Pazcaut/Amplificador-AB-100W/README.md

# Amplificador-AB-100W
Amplificador de potencia de audio en Clase AB de 100W sobre 8Ω

Diseño, testeo y análisis de un amplificador de audio AB.

Objetivos:
Analizar su funcionamiento y comparar la teoría con la realidad. 
Evaluar la calidad y la potencia de la señal de salida. 
Medir interferencia y la protección contra cortocircuitos. 

Todas las mediciones se realizaron sobre una carga de 8 ohms y luego se le conectó una señal de audio por celular y un parlante para corroborar el funcionamiento.
Se adjunta esquemático en KiCad y la comparación de cálculos teóricos con las mediciones en laboratorio, con sus respectivas capturas de pantalla del osciloscopio.
Fotografia de la placa terminada:
