Pazcaut/Amplificador-AB-100W/Ampli AB.pdf

# Amplificador AB

### CLASE AB 100W

PAZ CAUT VILLA

Electrónica Aplicada II

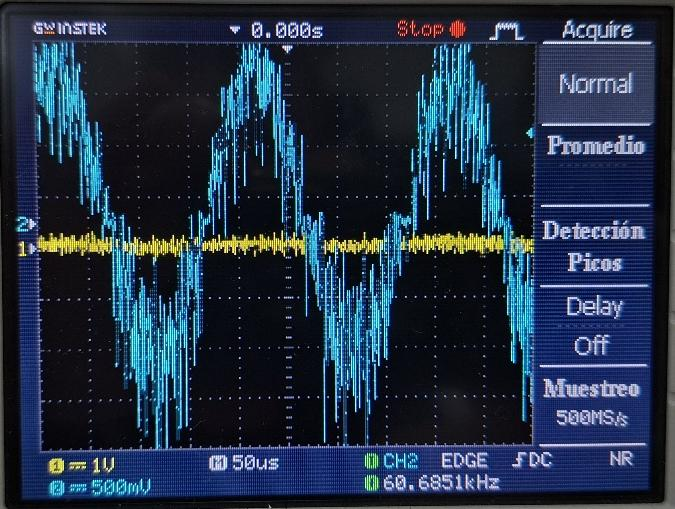
[picture p1: figure]

____________________________________________________________________________

Objetivos del trabajo

En el presente trabajo práctico, se realizaron mediciones sobre un amplificador de Potencia de audio en Clase AB de 100W sobre 8Ω.

La práctica permitió conocer y experimentar el funcionamiento de los principales bloques que comprende un amplificador de potencia de audio Clase AB discreto.

Antes de alimentar el circuito, se ajustó el preset RV1 en 0Ω. Esto asegura que no habrá corriente de reposo en los transistores de salida Q7 y Q8; o sea, que estarán en Clase B y no en Clase AB. Se conectó como carga, en lugar del parlante, una resistencia de 8Ω.

La prueba final, después de las mediciones, se realizó utilizando un parlante y música.

Mediciones a realizar

El circuito se alimentó con una fuente simétrica de Vcc = ±35V.

1. Nombrar cuál de las 4 topologías de realimentación (C-P, C-S, T-P, T-S) utiliza este circuito; y el tipo de amplificador (Avf, Aif, Rmf, Gmf) que es. Teniendo en cuenta solamente la red de realimentación Beta; calcular la Ganancia Realimentada (a Lazo cerrado) del circuito.

El circuito corresponde a un amplificador tensión- serie. Se muestrea tensión y se realimenta tensión. Por lo tanto, es un amplificador de tensión, con ganancia Avf.

La ganancia de lazo cerrado es:

Avf = 1 +

R3
R2

→ Avf = 1 +

3300
100

→ Avf = 34

### 2. Verificar la distorsión por cruce. Ajustar RV1 hasta observar su corrección. Colocar

capturas del osciloscopio antes y después de la corrección.

Señal de salida antes de corregir distorsión por cruce.

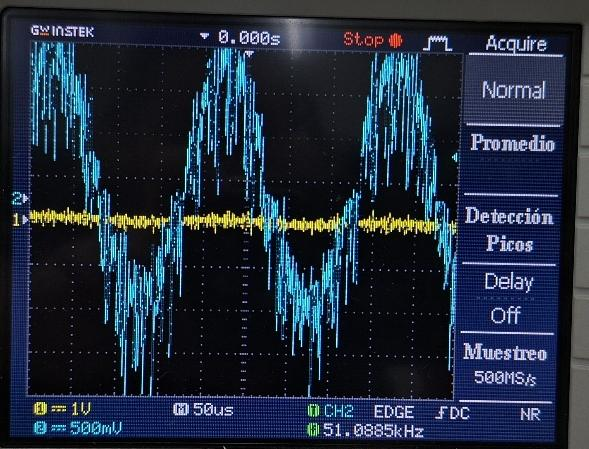
[picture p2: figure]

____________________________________________________________________________

Señal de salida después de corregir distorsión por cruce.

3. Medir los puntos Q de todos los transistores.
TR | VCEQ [v] | ICQ [mA]
Q1 | 29,62 | 1,28
Q2 | 30,24 | 1,28
Q3 | 28,52 | 1,54
Q4 | 3,78 | ~0
Q5 | 3,15 | ~0
Q6 | 2,04 | 1,04
Q7 | 29,7 | 1,03
4. Medir la máxima excursión de salida. Indicar la sensibilidad del amplificador (señal de entrada para obtener máxima señal de salida). Indicar si es simétrica la excursión. Calcular la ganancia de tensión. Colocar captura de pantalla del osciloscopio que compare señal de entrada y de salida.

La máxima excursión de salida se dio con Vo ≈ ±29.5V y con Vin = ±840mV

Av =

Vo
Vin

→ Av =

29.5V
840mV

→ Av = 35. 1

Se observó que la excursión de salida es practicamente simétrica.

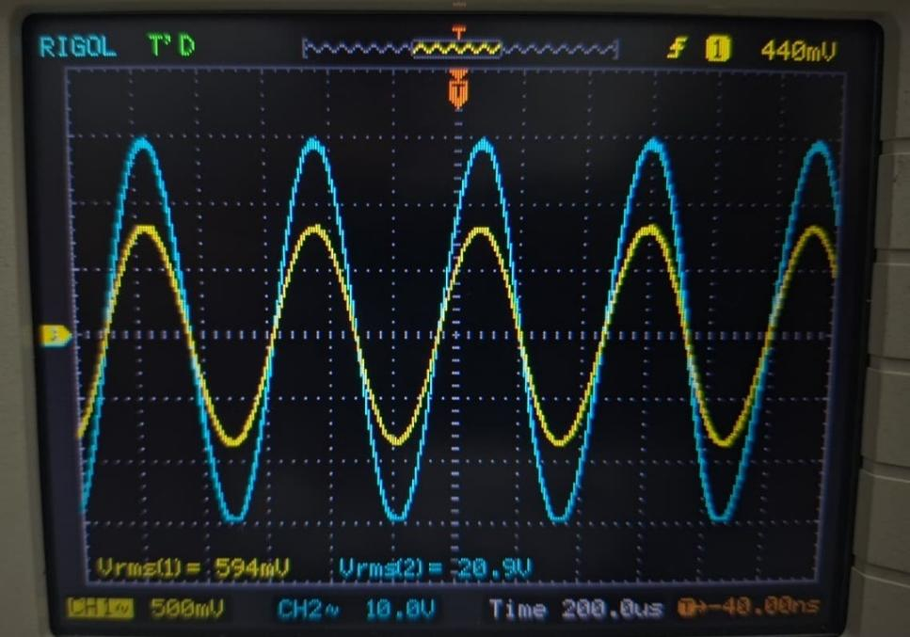
[picture p3: figure]
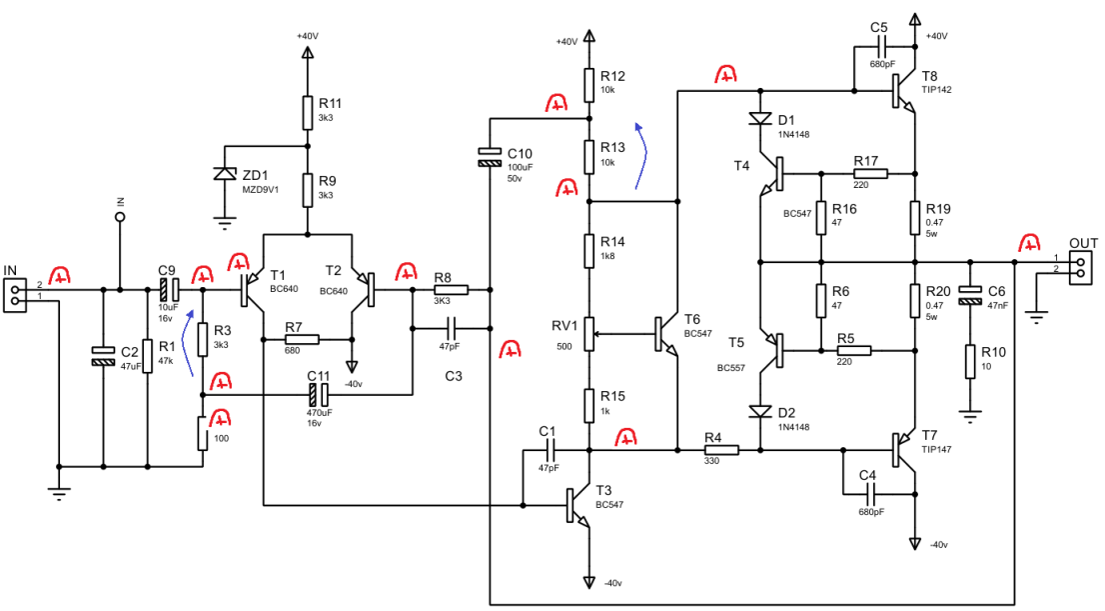
[picture p4: figure]

____________________________________________________________________________

Señal de salida (celeste) y señal de entrada (amarillo).

5. Verificar Bootstrap de entrada y de salida. Indicar cómo funciona y medir la tensión en los extremos de las resistencias involucradas, y realizar la resta de tensiones con el osciloscopio. Coloque una captura de pantalla del osciloscopio. Calcular la corriente de alterna que circula por dichas resistencias.

El Bootstrap se utiliza para aumentar la impedancia en alterna de una resistencia. En un extremo de la resistencia está presente determinada tensión de alterna. Mediante un capacitor, en el otro extremo se inyecta una tensión muy similar, haciendo que la caída de tensión en la resistencia sea casi nula, y no circule corriente.

En el siguiente circuito se observan el Bootstrap de entrada (conformado por C11 y R3) y el Bootstrap de salida (conformado por C10 y R12/13).

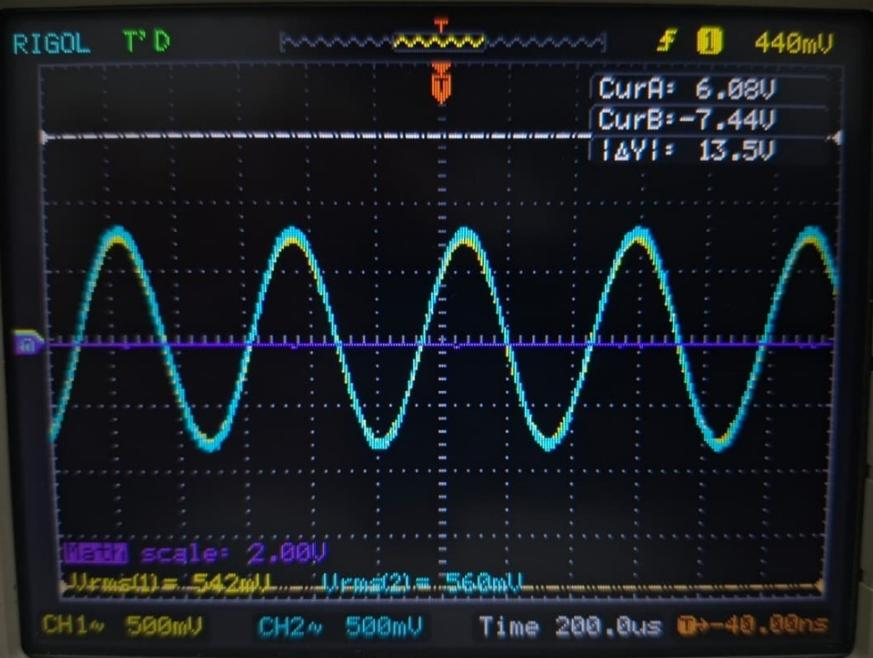
[picture p5: figure]
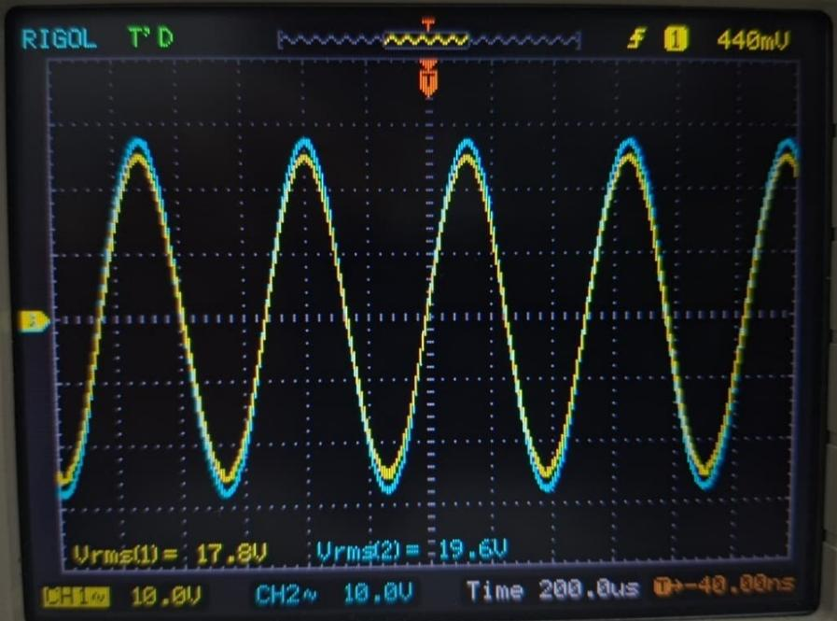
[picture p6: figure]

____________________________________________________________________________

La corriente que circula por las resistencias se obtiene observando la caída de tensión en el osciloscopio.

Bootstrap de entrada, compuesto por C11 y R3.

Bootstrap de salida, compuesto por C10 y R12/13. VR3 = (560mV − 542mV)√2 → VR3 = 25.5mV̂

VR13 = (19.6V − 17.8V)√2 → VR13 = 2.55 V̂

IR3 =

25.5mV̂
3300Ω

→ IR3 = 7. 7 uA

IR13 =

2.55V̂
10000Ω

→ IR13 = 255 uA

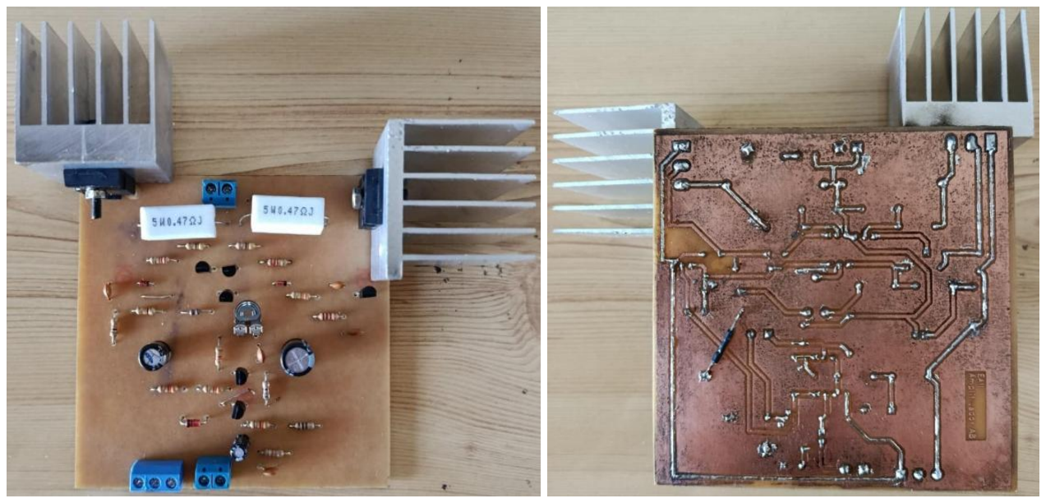
[picture p7: figure]

____________________________________________________________________________

6. Medir el rendimiento del amplificador.

PoutMáx Teo =

Vcc²
2 ∗ RL

→ PoutMáx Teo =

(35V)

2
2 ∗ 8Ω

→ PoutMáx Teo = 76. 6W

VoutMáx Real = (Vcc − 2) ∗

RL
RL + 0.47

→ VoutMáx Real = 29. 5V

PoutMáx Real =

VoutMáx Real

2
2 ∗ RL

→ PoutMáx Real =

(29.5V)

2
2 ∗ 8Ω

→ PoutMáx Real = 54. 4 W

Se midió la corriente entregada por la fuente con potencia de salida máxima:

Icc = 2.24A

Pcc = Vcc ∗ Icc → Pcc = 35V ∗ 2.24A → Pcc = 78. 5W

η% = 100 ∗

PoutMáx Real
Pcc

→ η% = 100 ∗

54.4W
78.5W

→ η% = 69. 32%

7. Verificar el funcionamiento de la protección contra corto circuitos, midiendo la tensión sobre R19.

Cuando comenzó a actuar la protección por cortocircuito, se midió sobre R19 tensión de 3.8V. Es decir, comenzó a actuar con la siguiente corriente de salida:

Iprot =

3.7V
0.47Ω

→ Iprot = 7. 8A

8. Fotografiar la placa del circuito.

Fotografía del PCB utilizado
